BlueBlueSkyZZ/PixelClock/README.md

# AWTRIX像素闹钟外壳设计

## 成品

像素闹钟

这是和朋友一起完成的**像素闹钟**，因为软件搭建部分都有详细的教程，所以本仓库主要是外壳的设计。

将文件转化为stl文件后可以交给淘宝店家进行定制。

其他的详细操作可以看我写的[这篇博文](https://blog.csdn.net/BlueBlueSkyZ/article/details/91636403)，该博文也借鉴了很多人的思路，文中都有列举。欢迎交流指正。

## 定制说明

淘宝店家：万晟工艺品加工（非打广告，大家随意）

### Part1

以下部件使用黑色半透明亚克力切割制作

1. 1-Back     背板，用于固定ESP8266，支撑脚以及充电宝等设备。
2. 2-Forward  面板，用于固定散光器件与光栅
3. 3-Side     侧板，Pixel的侧面，记得双份哟
4. 4-Bottom   底板，Pixel的下面，留有充电宝的接口
5. 5-Top      顶板，Pixel的上面

### Part2

以下部件使用树脂8000进行打印（未来工场）

1. 6-Support  板间支撑架，用于连接亚克力，作用类似角铁
2. 7-Feet     支撑脚，就和相框的支撑脚一样的作用哈
3. 8-Fix      固定器，用来固定充电宝的
4. 9-Grid     光栅，隔离每一个LED，记得喷漆黑色

### Part3

一些必要的零件，但并不需要定制

1. M3螺丝 
   1. 螺纹长度6mm，用于固定板间支撑架和亚克力板
   2. 螺纹长度20mm，用于固定背板上各种部件
2. M3螺母(有螺丝就有螺母23333)

3. 亚克力胶水 有机玻璃快干胶，没痕迹、

4. 8096胶水   一种可以把螺丝和树脂粘在一起的胶水

5. 家具脚垫   给Pixel装脚垫这样才不会磨损嘛 

-----

作者：pyk && BlueBlueSky
