BlueBlueSkyZZ/PixelClock/(list of files, cad)

Other CAD files:
1-Back.CATPart
2-Forward.CATPart
3-Side.CATPart
4-Bottom.CATPart
5-Top.CATPart
6-Support.CATPart
7-Feet.CATPart
8-Fix.CATPart
9-Grid.CATPart
